RajitTalluri/ASME_SDC_-25--26/Integration/Wiring Code.pdf

# Wiring

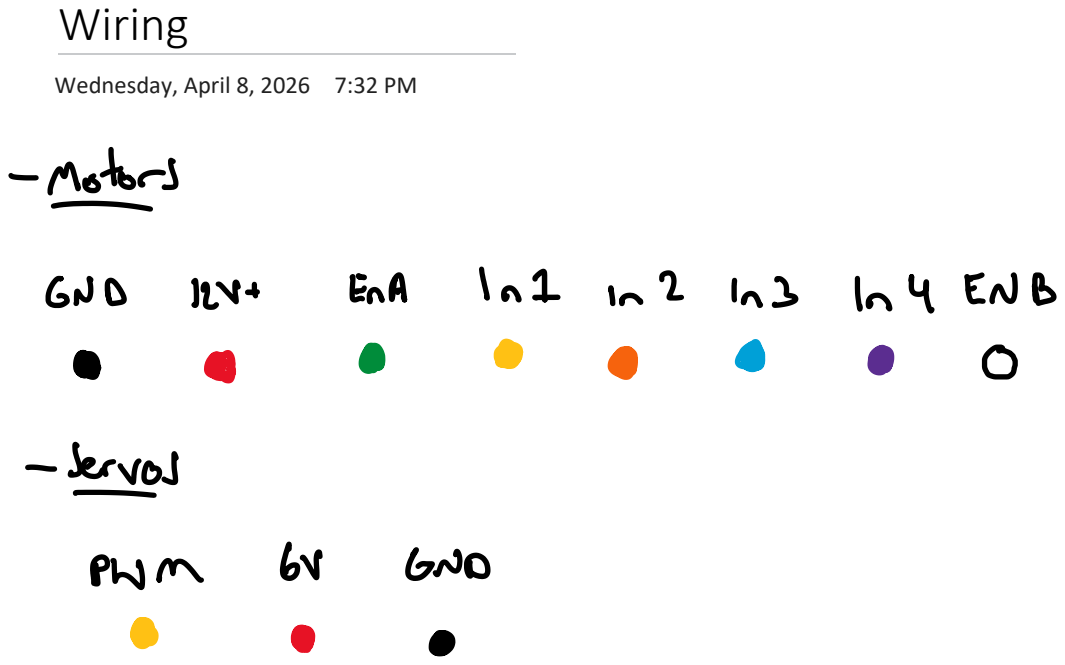
[picture p1: page 1]

Wednesday, April 8, 2026 7:32 PM
