RajitTalluri/ASME_SDC_-25--26/Integration/PCB_Files_V1/Mechatronics.kicad_pcb

## KiCad design Integration/PCB_Files_V1/Mechatronics.kicad_pcb (2026-03-23)

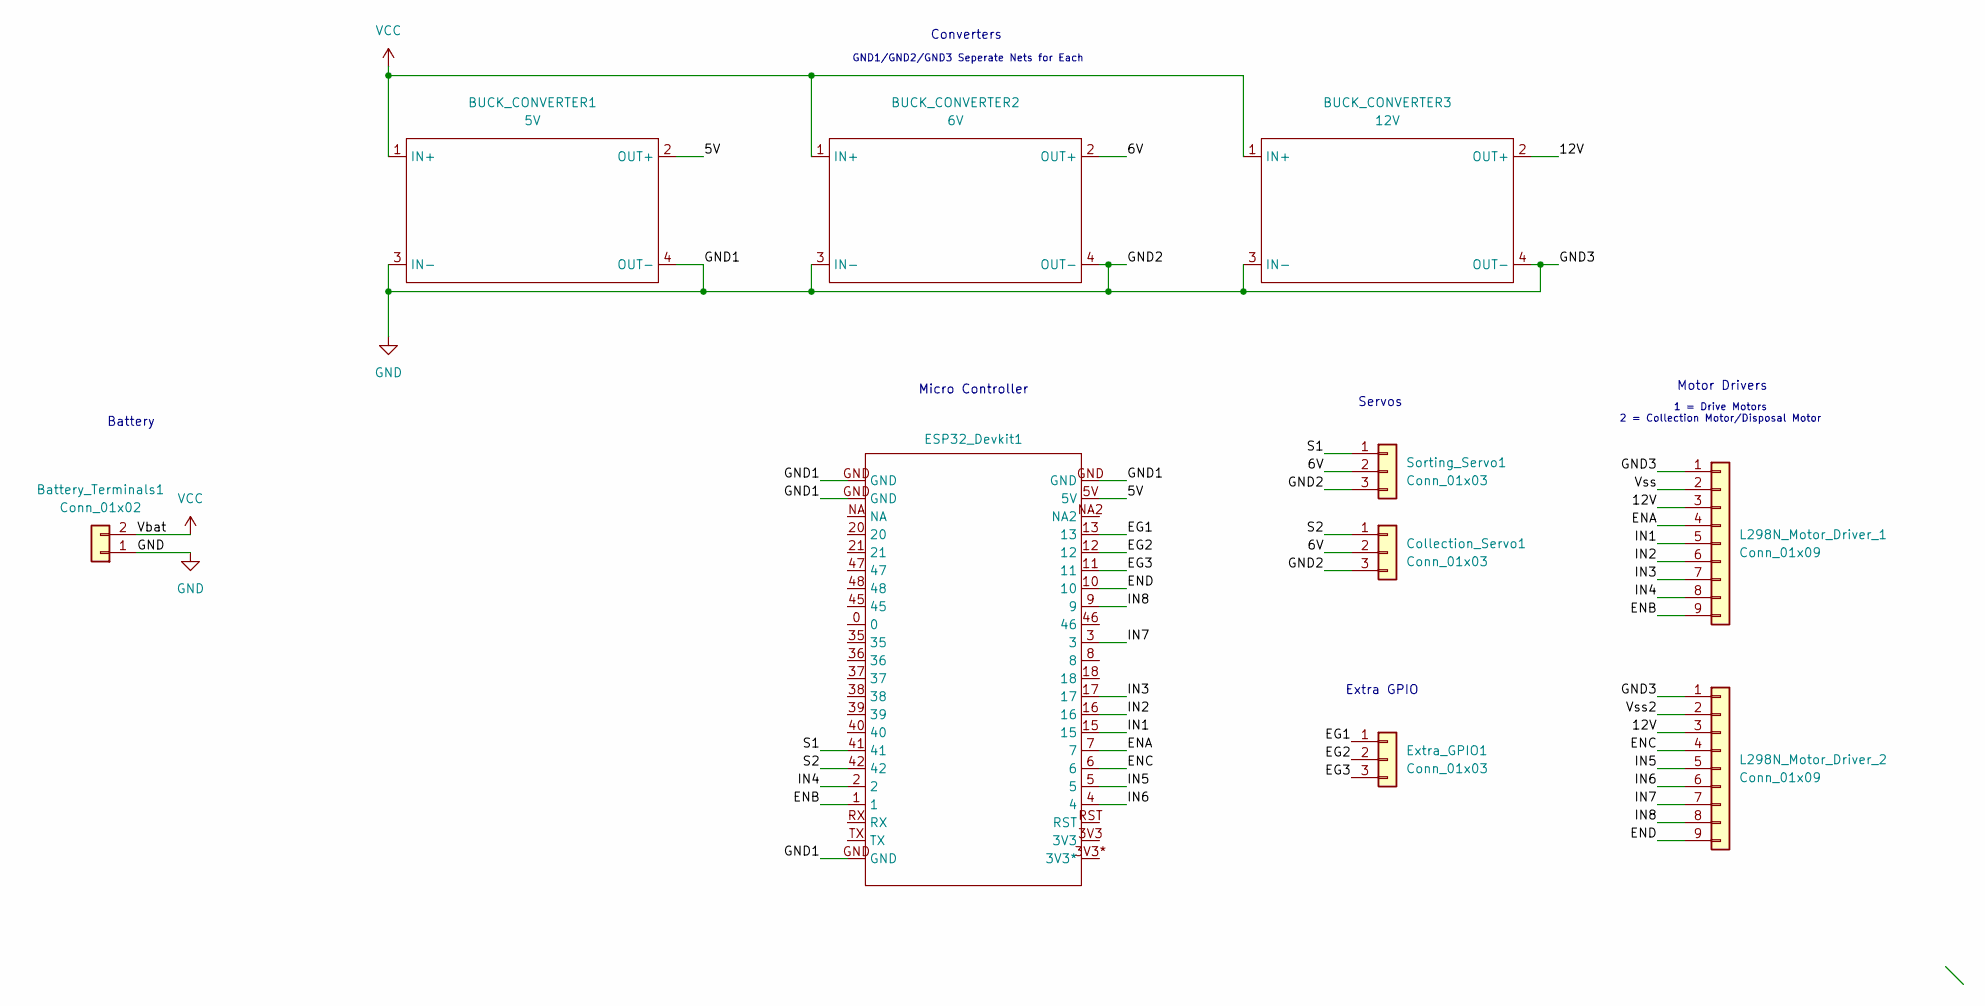
[picture p2: schematic Mechatronics.kicad_sch, Mechatronics SDP PCB 2026]

Parts:
BUCK_CONVERTER1: 5V; LM2596 BUCK CONVERTER MODULE
BUCK_CONVERTER2: 6V; LM2596 BUCK CONVERTER MODULE
BUCK_CONVERTER3: 12V; LM2596 BUCK CONVERTER MODULE
Battery_Terminals1: Conn_01x02; AMASS_XT60-F_1x02_P7.20mm_Vertical
Collection_Servo1: Conn_01x03; PinHeader_1x03_P2.54mm_Vertical
ESP32_Devkit1: ESP32DEVKIT
Extra_GPIO1: Conn_01x03; PinHeader_1x03_P2.54mm_Vertical
L298N_Motor_Driver_1, L298N_Motor_Driver_2: Conn_01x09; PinHeader_1x09_P2.54mm_Vertical
Sorting_Servo1: Conn_01x03; PinHeader_1x03_P2.54mm_Vertical

Connections:
/5V: BUCK_CONVERTER1.2 (OUT+), ESP32_Devkit1.5V
/6V: BUCK_CONVERTER2.2 (OUT+), Collection_Servo1.2, Sorting_Servo1.2
/12V: BUCK_CONVERTER3.2 (OUT+), L298N_Motor_Driver_1.3, L298N_Motor_Driver_2.3
/EG1: ESP32_Devkit1.13, Extra_GPIO1.1
/EG2: ESP32_Devkit1.12, Extra_GPIO1.2
/EG3: ESP32_Devkit1.11, Extra_GPIO1.3
/ENA: ESP32_Devkit1.7, L298N_Motor_Driver_1.4
/ENB: ESP32_Devkit1.1, L298N_Motor_Driver_1.9
/ENC: ESP32_Devkit1.6, L298N_Motor_Driver_2.4
/END: ESP32_Devkit1.10, L298N_Motor_Driver_2.9
/IN1: ESP32_Devkit1.15, L298N_Motor_Driver_1.5
/IN2: ESP32_Devkit1.16, L298N_Motor_Driver_1.6
/IN3: ESP32_Devkit1.17, L298N_Motor_Driver_1.7
/IN4: ESP32_Devkit1.2, L298N_Motor_Driver_1.8
/IN5: ESP32_Devkit1.5, L298N_Motor_Driver_2.5
/IN6: ESP32_Devkit1.4, L298N_Motor_Driver_2.6
/IN7: ESP32_Devkit1.3, L298N_Motor_Driver_2.7
/IN8: ESP32_Devkit1.9, L298N_Motor_Driver_2.8
/S1: ESP32_Devkit1.41, Sorting_Servo1.1
/S2: Collection_Servo1.1, ESP32_Devkit1.42
/Vss: L298N_Motor_Driver_1.2
/Vss2: L298N_Motor_Driver_2.2
GND: BUCK_CONVERTER1.3 (IN-), BUCK_CONVERTER1.4 (OUT-), BUCK_CONVERTER2.3 (IN-), BUCK_CONVERTER2.4 (OUT-), BUCK_CONVERTER3.3 (IN-), BUCK_CONVERTER3.4 (OUT-), Battery_Terminals1.1, Collection_Servo1.3, ESP32_Devkit1.GND, L298N_Motor_Driver_1.1, L298N_Motor_Driver_2.1, Sorting_Servo1.3
VCC: BUCK_CONVERTER1.1 (IN+), BUCK_CONVERTER2.1 (IN+), BUCK_CONVERTER3.1 (IN+), Battery_Terminals1.2

Notes on the sheet:
Micro Controller
Extra GPIO
Motor Drivers
Battery
1 = Drive Motors 2 = Collection Motor/Disposal Motor
Converters
GND1/GND2/GND3 Seperate Nets for Each
Servos

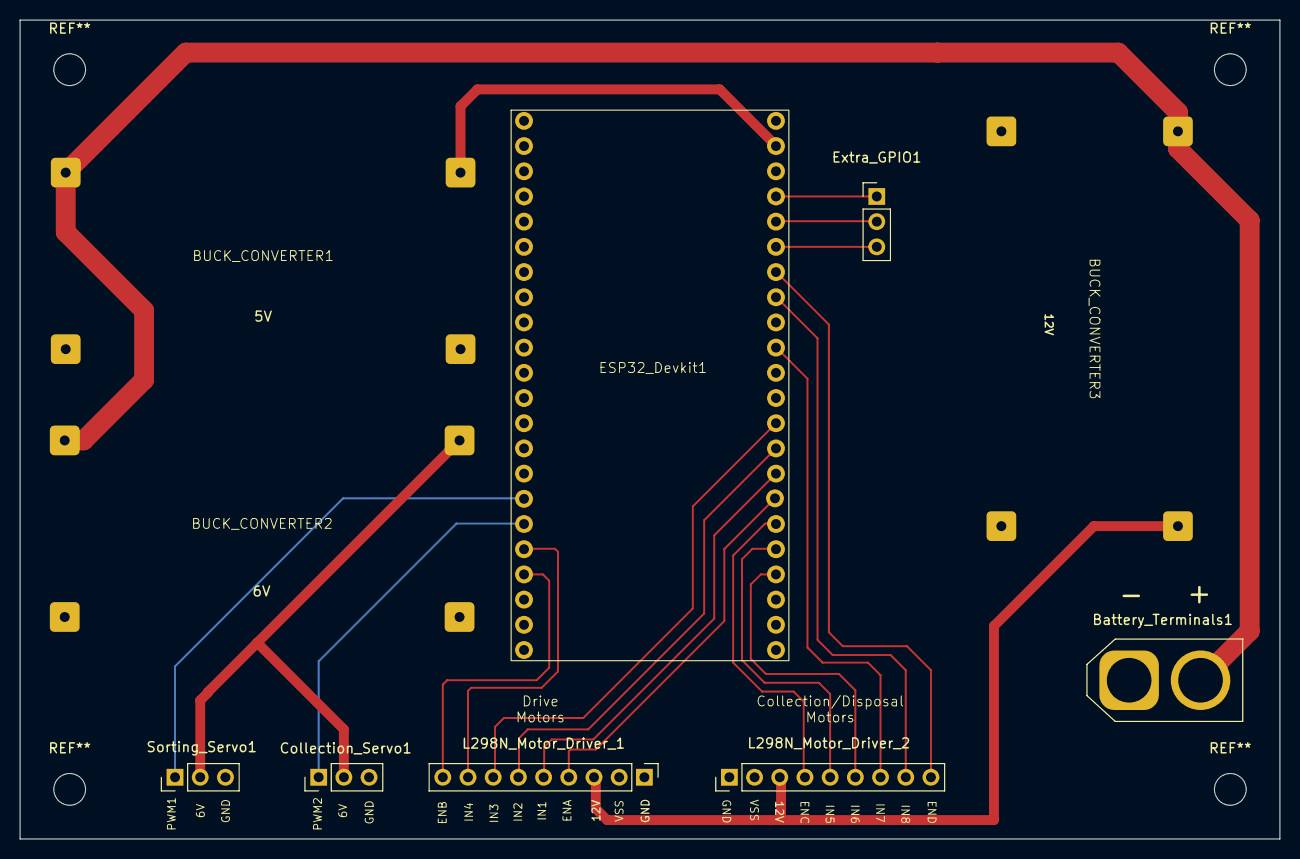
[picture p3: board Mechatronics.kicad_pcb from above]

Board: 2 copper layers, 127.0 x 82.5 mm, 10 parts (0 on the bottom side), 22 nets.
