RajitTalluri/ASME_SDC_-25--26/colorsensor/Arduino/colorSensorAMSE.ino

/*
TCS3200 color sensos
Datasheet: https://www.mouser.com/catalog/specsheets/tcs3200-e11.pdf
*/

// define pins
const int S0 = 8;
const int S1 = 9;
const int S2 = 10;
const int S3 = 11;
const int signal = 12;

// LED pins
const int redLED = 10;
const int greenLED = 9;
const int blueLED = 8;

// define variables for pulses
unsigned long red;
unsigned long blue;
unsigned long green;
unsigned long clear;

void setup() {  // put your setup code here, to run once:
  // set pin modes
  pinMode(S0, OUTPUT);
  pinMode(S1, OUTPUT);
  pinMode(S2, OUTPUT);
  pinMode(S3, OUTPUT);
  pinMode(signal, INPUT);
  pinMode(redLED, OUTPUT);
  pinMode(greenLED, OUTPUT);
  pinMode(blueLED, OUTPUT);

  /* set frequency scaling - 
     S0 S1 | Output frequency scaling
     L  L  | power down
     L  H  | 2%
     H  L  | 20%
     H  H  | 100%
  */
  digitalWrite(S0, HIGH);
  digitalWrite(S1, LOW);

  // initialize serial communication
  Serial.begin(9600); // Baude rate set to 9600
}

void loop() {  // put your main code here, to run repeatedly:
  /* cycle through each filter type and use the pulseIn command to measure pulse length.
  Frequency *increases* with more light, so the pulse length will *decrease*.
  /  S2 S3 | Photodiode Type
     L  L  | Red
     L  H  | Blue
     H  L  | Clear (no filter)
     H  H  | Green
  */

  // clear filter
  digitalWrite(S2, HIGH);
  digitalWrite(S3, LOW);
  clear = pulseIn(signal, HIGH);

  // red filter
  digitalWrite(S2, LOW);
  digitalWrite(S3, LOW);
  red = pulseIn(signal, HIGH);

  // green filter
  digitalWrite(S2, HIGH);
  digitalWrite(S3, HIGH);
  green = pulseIn(signal, HIGH);

  // blue filter
  digitalWrite(S2, LOW);
  digitalWrite(S3, HIGH);
  blue = pulseIn(signal, HIGH);

  /* map the red, green, and blue values to a more intuitive 0-255 range where
     0 means less light and 255 means more. This part will require calibration
     depending on your colored surfaces and ambient light levels.
  */
  red = map(red, 164, 25, 0, 255);
  green = map(green, 191, 29, 0, 255);
  blue = map(blue, 162, 25, 0, 255);

  // turn LEDs on depending on which color is detected
  if (red > 200 && green < 100 && blue < 100) {  // red detected
    digitalWrite(redLED, HIGH);
    digitalWrite(greenLED, LOW);
    digitalWrite(blueLED, LOW);
  } else if (red < 100 && green > 150 && blue < 150) {  // green detected
    digitalWrite(redLED, LOW);
    digitalWrite(greenLED, HIGH);
    digitalWrite(blueLED, LOW);
  } else if (red < 100 && green < 100 && blue > 80) {  // blue detected
    digitalWrite(redLED, LOW);
    digitalWrite(greenLED, LOW);
    digitalWrite(blueLED, HIGH);
  } else {  // none of the three colors above detected
    //digitalWrite(redLED,LOW);
    //digitalWrite(greenLED,LOW);
    //digitalWrite(blueLED,LOW);
  }

  // print readings

  Serial.print("Red: ");
  Serial.print(red);
  Serial.print(" | Green: ");
  Serial.print(green);
  Serial.print(" | Blue: ");
  Serial.println(blue);

  delay(1000);
}
