RajitTalluri/ASME_SDC_-25--26/colorsensor/Arduino/test0.1_NN_weights.h

#ifndef MODEL_WEIGHTS_H
#define MODEL_WEIGHTS_H

// Layer 1: 3 inputs -> 64 outputs
const float W1[3][64] = {
  {-0.07613645f, -0.52328700f, 0.43620253f, 0.26489195f, 0.11676812f, -0.31233880f, 0.19923908f, 0.39142382f, 0.13459533f, 0.27544421f, 0.03939587f, 0.31791449f, 0.78663355f, 0.85602796f, 0.37938905f, 0.12901723f, -0.25851876f, -0.06917451f, 0.50231624f, 0.61964959f, -1.07706153f, -0.35184926f, 0.26312631f, 0.90019727f, 1.00066960f, -0.45232561f, -0.92579341f, 0.97923893f, -0.20663147f, 0.14425248f, 0.21627098f, -0.88646525f, -0.23749414f, -0.35812882f, -0.63191587f, 0.39240837f, 0.04877532f, -0.04918748f, 0.38625127f, 0.55342841f, -0.35178035f, -0.81580162f, 0.37917501f, 0.20561826f, -0.56457645f, -0.18627068f, 0.62333775f, 0.53070271f, -0.37990719f, -0.54927236f, 0.01317303f, -0.61856622f, 0.39745814f, -0.44331181f, -0.17329776f, -0.35466480f, 0.67389458f, -0.46904629f, -0.16700844f, 0.74921262f, -0.01836676f, -0.10077527f, 1.24129975f, -0.31303802f},
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
};

// Layer 4: Biases, 1 output
const float b4 = 0.55884057f;

#endif // MODEL_WEIGHTS_H
