RajitTalluri/ASME_SDC_-25--26/(commit log)

2025-10-27 Remove unnecessary comments on LED pin usage
    Removed comments about sensor LED pin configuration.
2025-12-09 Add files via upload
    Arduino Script that calibrates white then black at start to cater for different environments. High values across for white and low values across for black.
2025-12-09 Added delays to calibration section
    Added delays and improved calibration messages for clarity.
2025-12-09 Create ArduinoColorSensor
2025-12-09 add file for color sensor data to csv file
    This script collects RGB data from an Arduino and saves it to a CSV file. It allows users to mark object changes using the spacebar.
2025-12-16 Refactor labeling mode to support individual samples
    Updated labeling functionality to allow individual sample labeling instead of range-based labeling. Adjusted print statements for clarity and updated file handling for labeled data.
2025-12-21 Add files via upload
    Total samples: 118
    Category distribution:
    neither: 58 samples (49.2%)
    green: 35 samples (29.7%)
    blue: 25 samples (21.2%)
    [labeled_data.csv, raw_data.csv, training_data.csv]
2025-12-21 Preprocessed data to be in 0-1 range and started script 3
    [trial_1_preprocessed.csv]
2025-12-28 Chnaged labels to integer values and wrote training script
    [trialdata2.csv]
2025-12-29 Removed voltage bubbles
2025-12-29 Combined preprocessing 2.1 and 2.2 into single script. Fixed typos in file/folder names
    [2.1_preprocess_data.py]
2026-02-01 Revise data collection procedure and sample guidelines
2026-02-03 Updated diagram, not complete yet
    [trial_1_preprocessed.csv, trialdata2.csv]
2026-02-04 Early stage BLE xbox script
2026-02-05 Initial script to rotate servo using xbox controller
2026-02-12 Current Projected Button Mapping
2026-02-12 Updated XBox controller to Servo script
2026-02-19 test commit
    [ASMEcolor_data.csv, labeled_data.csv, raw_data.csv, training_data.csv, trial_1_preprocessed.csv, trialdata2.csv]
2026-02-19 Update controller button mapping for grabber and drivetrain
2026-02-26 Added drivetrain functions to BLE script
2026-02-27 Made pivots analog and to trigger, added servo features
2026-02-27 added pin numnbers and collection dc motor driver
2026-03-11 updated button mappings
2026-03-23 PCB_V1
    Need to reassign footprint and symbol library locations for ESP32 + Buck Converters
    [Mechatronics.kicad_pcb, Mechatronics.kicad_sch]
2026-03-30 Add files via upload
    Arduino script to control the sorting microservo.
2026-03-30 Added disposal dc motor control
2026-04-06 Update motor pin assignments and speeds in BLE_Xbox
2026-04-08 reorganize: repo
    [ASMEcolor_data.csv]
2026-04-09 Add BLE controller integration for drivetrain control
2026-04-16 Fixed drivetrain and added gradual steering
    [BLE_Xbox.ino]
2026-04-26 Wiring Code for GPIO Connections
